sirshuoshuo/Dual-Channel-Simultaneous-Interpretation/README.md

# Dual-Channel-Simultaneous-Interpretation

Detailed information can be seen in the pdf, which include all the module we use and our basic ideas.
