sirshuoshuo/Dual-Channel-Simultaneous-Interpretation/report-双路语音同传.pdf

## 模拟电路实验 diy 项目结题报告——双路语音同传系统的制作

By 李梓源 李沅朔 徐焓茁 潘耿炜

1.项目背景

“双路语音同传”系统，顾名思义，是一种能够同时传输两个语音信号的系统。这种系统的设计 背景主要体现在国际会议、双语教学和跨国商业合作中。同时传输两路语音信号的设计能够同时给不同 语言的参与者发送不同语言的讲话内容，从而实现无障碍沟通。 这一个系统的核心技术包括 FM 调 制，频分复用技术，无线收发技术等。通过这个项目，我们可以将课堂上学到的电子理论知识，如电路 分析、信号处理、单片机编程等应用于实际设计中，加深理解，并掌握多种电子技术在真实世界中的应 用方法。总体的设计与组装过程涵盖了电路设计、PCB 布局布线、元器件选择与采购、焊接与装配、 调试与测试等多个环节，有助于我们掌握电子工程领域必备的工程技术与技能。这个系统的搭建还需要 团队协作，能够锻炼了我们的的沟通与合作能力，让我们学习到如何在团队中分配任务、协调进度，以 及有效沟通设计理念和解决方案。本项目不仅是对技术能力的全面考验，更是对我们成为具备实战能 力、创新思维和良好职业素养的电子工程师的良好锻炼。

## 2.项目组成（基础部分）

### 2.1 发射端

2.1.1 电路拓扑

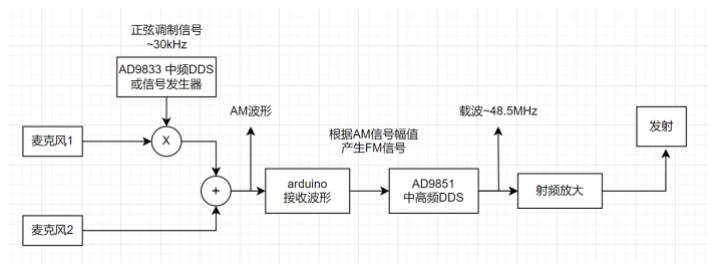
[picture p1: figure]

在这个系统中，两个麦克风分别接受语音信号，
并将振动信号转换为模拟的电信号。一路信号在
之后通过乘法器与 AD9833 发出的中低频载波
信号（约为 30kHz）相乘，进行 AM 调制，将
这一路信号（下称 A 路信号）调制到相对较高
的频段，与另一路信号（B 路信号）形成基于
AM 调制的频分复用。A 路信号之后与 B 路信号
通过加法器相加。之后，arduino 会接受这一个
AM 波形，读取其幅值。之后，根据幅值的波
动，arduino 会动态调整 AD9851 产生信号的频 率，使其在载波附近根据信号幅值波动，完成
FM 调制。之后，FM 调制的信号通过射频放大
模块和天线发射到无线信道中。

2.1.2 硬件原理

1. 驻极体麦克风

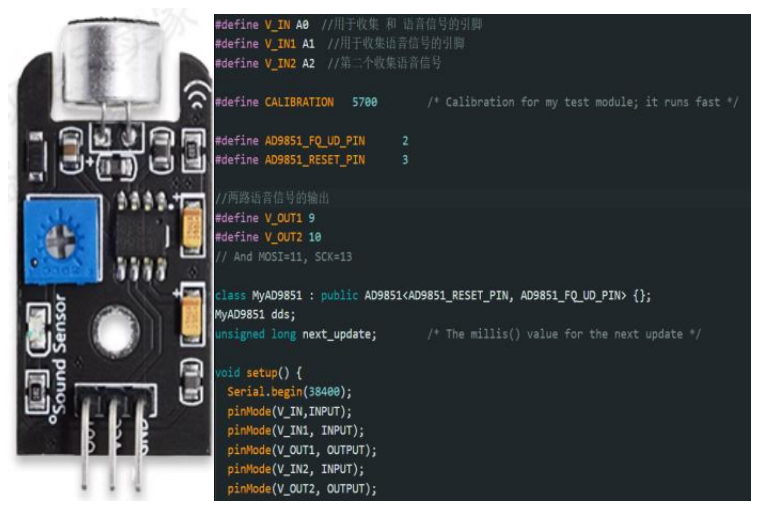
[picture p2: figure]

驻极体麦克风模块是一个将语音信号转换为模拟
电信号的语音接收模块。利用 Arduino UNO 可 直接获得输入语音信号。在本项目中，由于为双
路语音同传，因此使用两个驻极体麦克模块。在
左侧的调试代码中，定义接受引脚为模拟输入
A0 和 A1。

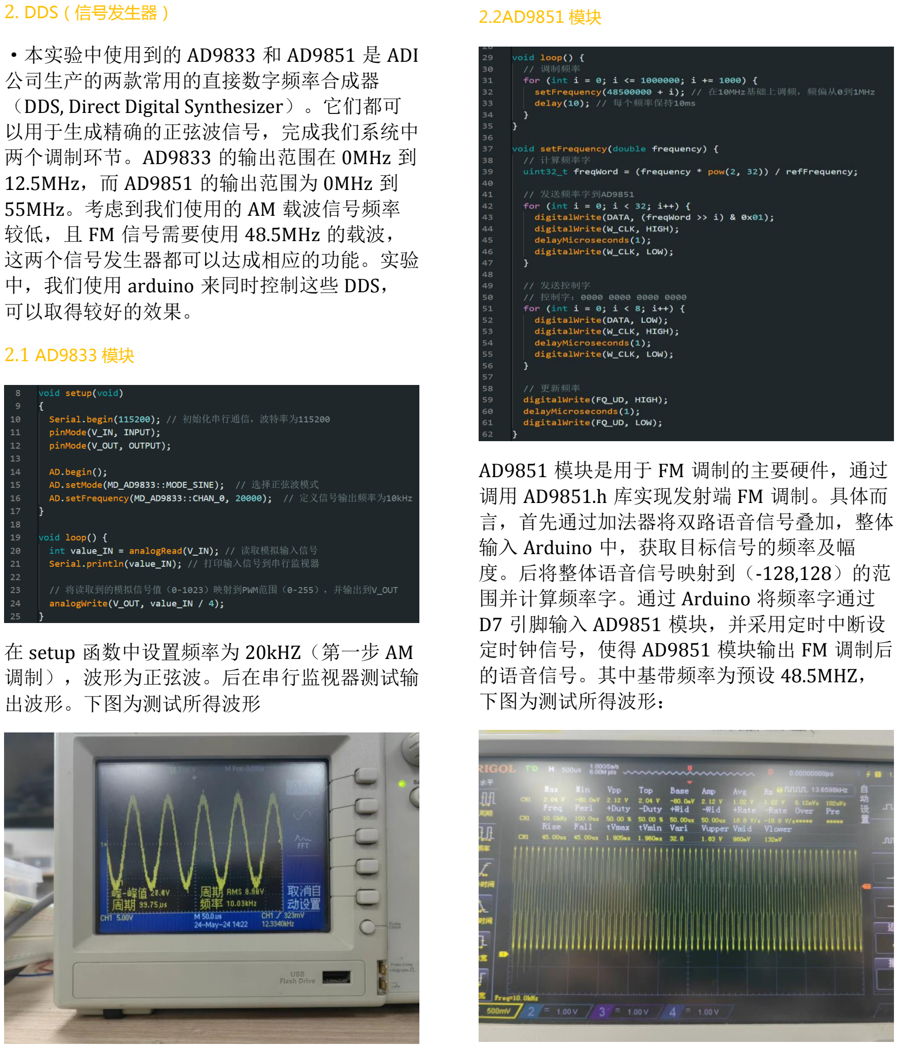
[picture p3: page 2]

2. DDS（信号发生器）

·本实验中使用到的 AD9833 和 AD9851 是 ADI 公司生产的两款常用的直接数字频率合成器
（DDS, Direct Digital Synthesizer）。它们都可 以用于生成精确的正弦波信号，完成我们系统中
两个调制环节。AD9833 的输出范围在 0MHz 到 12.5MHz，而 AD9851 的输出范围为 0MHz 到 55MHz。考虑到我们使用的 AM 载波信号频率
较低，且 FM 信号需要使用 48.5MHz 的载波， 这两个信号发生器都可以达成相应的功能。实验
中，我们使用 arduino 来同时控制这些 DDS， 可以取得较好的效果。

2.1 AD9833 模块

在 setup 函数中设置频率为 20kHZ（第一步 AM 调制），波形为正弦波。后在串行监视器测试输
出波形。下图为测试所得波形

2.2AD9851 模块

AD9851 模块是用于 FM 调制的主要硬件，通过 调用 AD9851.h 库实现发射端 FM 调制。具体而 言，首先通过加法器将双路语音信号叠加，整体
输入 Arduino 中，获取目标信号的频率及幅
度。后将整体语音信号映射到（-128,128）的范
围并计算频率字。通过 Arduino 将频率字通过
D7 引脚输入 AD9851 模块，并采用定时中断设 定时钟信号，使得 AD9851 模块输出 FM 调制后 的语音信号。其中基带频率为预设 48.5MHZ，
下图为测试所得波形：

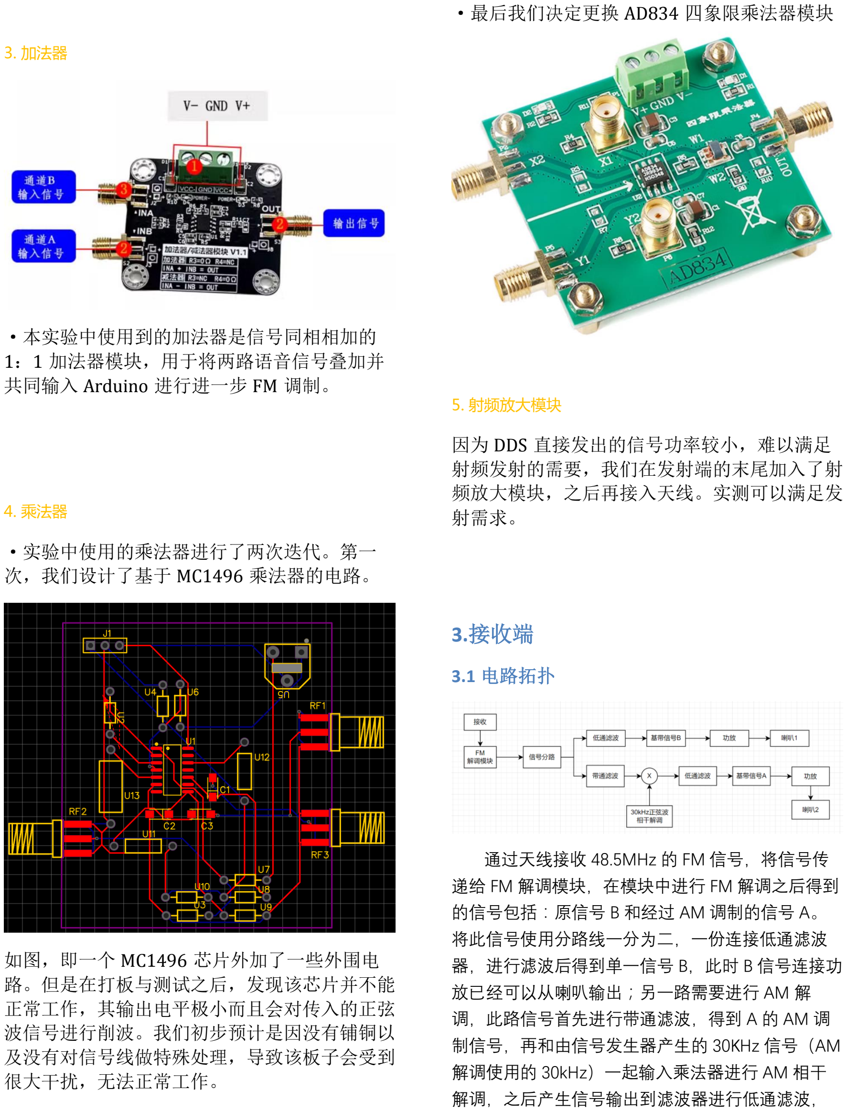
[picture p4: page 3]

3. 加法器

·本实验中使用到的加法器是信号同相相加的
1：1 加法器模块，用于将两路语音信号叠加并
共同输入 Arduino 进行进一步 FM 调制。
4. 乘法器

·实验中使用的乘法器进行了两次迭代。第一
次，我们设计了基于 MC1496 乘法器的电路。

如图，即一个 MC1496 芯片外加了一些外围电
路。但是在打板与测试之后，发现该芯片并不能
正常工作，其输出电平极小而且会对传入的正弦
波信号进行削波。我们初步预计是因没有铺铜以
及没有对信号线做特殊处理，导致该板子会受到
很大干扰，无法正常工作。

·最后我们决定更换 AD834 四象限乘法器模块

5. 射频放大模块

因为 DDS 直接发出的信号功率较小，难以满足
射频发射的需要，我们在发射端的末尾加入了射
频放大模块，之后再接入天线。实测可以满足发
射需求。

3.接收端

### 3.1 电路拓扑

通过天线接收 48.5MHz 的 FM 信号，将信号传 递给 FM 解调模块，在模块中进行 FM 解调之后得到 的信号包括：原信号 B 和经过 AM 调制的信号 A。 将此信号使用分路线一分为二，一份连接低通滤波
器，进行滤波后得到单一信号 B，此时 B 信号连接功 放已经可以从喇叭输出；另一路需要进行 AM 解
调，此路信号首先进行带通滤波，得到 A 的 AM 调 制信号，再和由信号发生器产生的 30KHz 信号（AM 解调使用的 30kHz）一起输入乘法器进行 AM 相干 解调，之后产生信号输出到滤波器进行低通滤波，

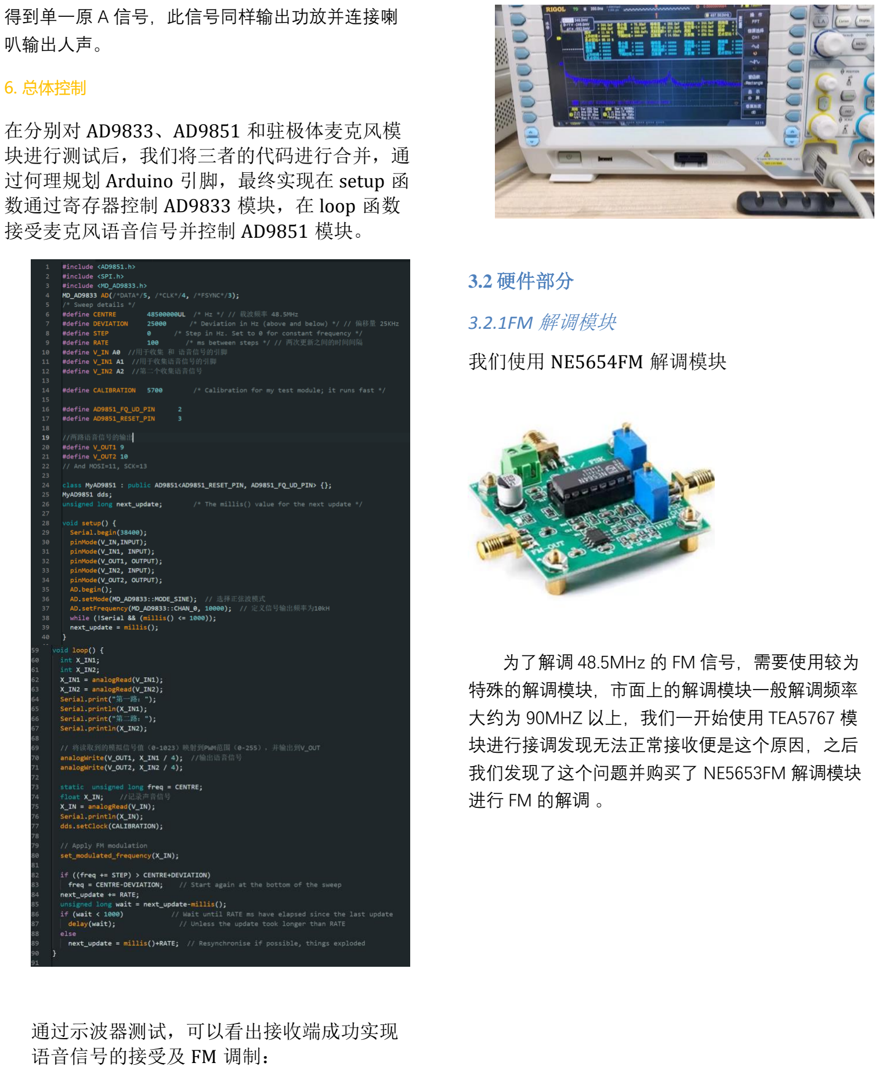
[picture p5: page 4]

得到单一原 A 信号，此信号同样输出功放并连接喇
叭输出人声。
6. 总体控制

在分别对 AD9833、AD9851 和驻极体麦克风模 块进行测试后，我们将三者的代码进行合并，通
过何理规划 Arduino 引脚，最终实现在 setup 函 数通过寄存器控制 AD9833 模块，在 loop 函数 接受麦克风语音信号并控制 AD9851 模块。

通过示波器测试，可以看出接收端成功实现
语音信号的接受及 FM 调制：

### 3.2 硬件部分

3.2.1FM 解调模块

我们使用 NE5654FM 解调模块

为了解调 48.5MHz 的 FM 信号，需要使用较为 特殊的解调模块，市面上的解调模块一般解调频率
大约为 90MHZ 以上，我们一开始使用 TEA5767 模 块进行接调发现无法正常接收便是这个原因，之后
我们发现了这个问题并购买了 NE5653FM 解调模块 进行 FM 的解调 。

3.2.2UAF42 滤波器

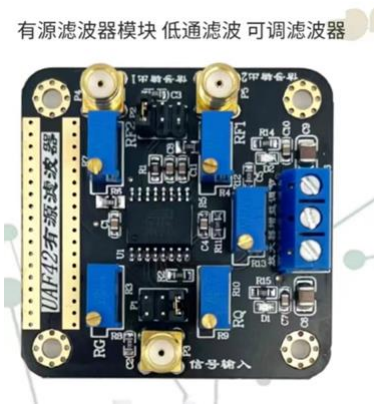
[picture p6: figure]

接收模块对滤波的需求较大，总共使用了三个滤
波器，我们选择 UAF42 滤波器作为滤波模块，此滤 波器可以通过调节跳线帽进行低通，带通，高通滤
波，并且此滤波器无法通过 arduino 进行设置，需要 人为调制。调试方法为通过改变滤波器上的电阻阻
值测试滤波效果，以得到合适的滤波区间，这一步
我们使用了信号发生器和滤波器进行，通过改变信
号发生器的频率，首先找到原滤波区间，然后不断
调节滤波器电阻阻值和信号频率观察示波器，最终
达到合适的滤波功能。在这一步中受到了不小的阻
力，此滤波器给的参考资料不够完善导致很难调节
滤波范围，如：原准备将低通的截止频率设置为
2kHz（人声音频率的范围为 0~2kHz），太难实现， 退而求其次只能将 AM 调制的频率升高至 30KHz， 并将滤波器的截止频率设置为 30KHz，这样才完成
滤波器的设置任务（此滤波器不建议购买使用，较
难调且给的教程不完善）。
3.3. 完整的双路语音同传系统展示

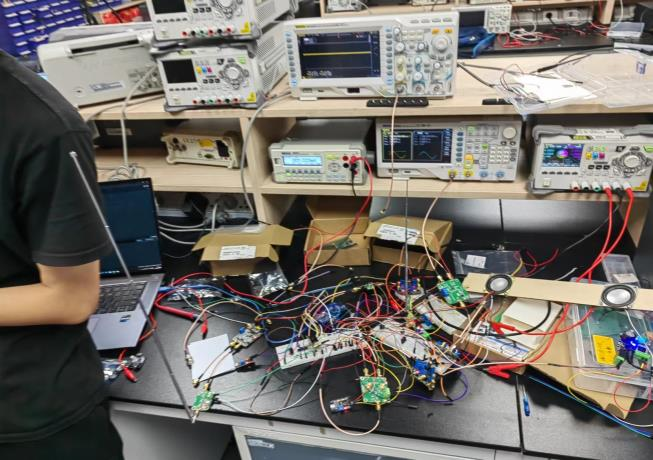
[picture p7: figure]

## 3 主要工作内容及收获

3.1 项目设计主要难点

项目的一个难点在于指定的 FM 调制频率不在传统的民 用传输频率当中（通常为 76-108MHz），需要我们自 行设计调制电路，同时也需要用到特殊的解调电路才可
以正常进行信号收发。

在进行解调时，需要对各个滤波器，乘法器等模块进行
调试配置，才可以清晰解调。

3.2 pcb 绘制

因为是第一次绘制 PCB，使用了嘉立创的自动布线。
实际测试下来，乘法器的异常很可能是因为自动布线缺
乏了对信号保护的考虑。

应该在嘉立创专业版中进行绘制，做好铺铜与信号保
护。

同时，发现立创商城对穿孔元件的支持较差，了解到了
在自主设计 PCB 时最好都使用标准的贴片元件（如
0603 封装）。
3.3. 项目整体布线

因为我们使用的模块较多，在装配后期各种杜邦线已经
较为凌乱，这很大程度上阻碍了检查，同时给信号带来
了较大的干扰。以后可以使用螺丝钉+木板的方案固定
各个模块，同时给板子设计统一的供电，尽量少用杜邦

线进行连接，来确保信号的完整性，提高项目的整洁
性，方便检修。

同时，在信号线较多时，应该采用带有屏蔽的借口，例
用 SMA 借口进行调试，还可以直接将 SMA 接口接入 示波器，方便观察波形。

3.4 软件及硬件调试

由于项目发射端的 FM 调制要求的载波频率较为特殊， 因此不能使用传统的硬件模块进行信号发射。在芯片的
控制上，需要分别完成信号的采集、信号处理以及定时
控制。这一过程涉及 setup 阶段和 loop 中同时控制四个 不同模块。这不仅需要代码的逻辑清晰，还要求对单片
机引脚的使用进行规划，否则可能导致电路接线复杂。

在硬件的调试上，我们采取的基本策略是先分别对单个
元件进行功能检测，再完成单一功能模块的合并，最后
整体测试。这样的方式虽然准确性较高，但耗时较长，
下次进行相关项目时可以采用并行测试，即直接对整个
对功能模块测试，再通过示波器或电压表排查出的问题
对单一模块的代码逻辑进行修改。
